johnMamish/soil-power/RL energy board/raspberry-pi-software/logger/test_server.py

import logging
from flask import Flask, request
app = Flask(__name__)

@app.route('/', methods=['POST', 'GET'], defaults={'path': ''})
@app.route('/<path:path>', methods=['POST', 'GET'])
def index(path):
    print("HTTP {} to URL /{} received JSON {}".format(request.method, path, request.get_json()))
    return "True"
