johnMamish/soil-power/(commit log)

2023-01-28 initial RL board design wip
    [rl_energy_board.brd, rl_energy_board.sch]
2024-02-15 add raspberry pi README and existing raspberry pi software
2024-02-15 ADC passes smoke test; need to validate current measurements still and quantify ADC accuracy / precision.
2024-02-15 add gaincal settings to ADC; performance now accurate to ~1mV
2024-07-01 Add logging framework
2024-08-06 PCB rev almost ready
    [rl_energy_board.brd, rl_energy_board.sch]
