johnMamish/soil-power/(notices)

Notices in the files:
parts and their libraries:
SparkFun-Connectors: Licensing: Creative Commons ShareAlike 4.0 International - https://creativecommons.org/licenses/by-sa/4.0
txu0101qdckrq1: COPYRIGHT: Copyright (C) 2024 Ultra Librarian. All rights reserved.
